Whitebowfr/esp32-poe/BOM.xlsx

BOM pour ESP32-PoE
Nom | Lien | Quantité | Prix total | Remarques
PCB | jlcpcb.com | 5 | 3.2 | (livraison incluse) | TOTAL
ESP-WROOM-32E 4MB | https://www.aliexpress.com/item/1005001560958763.html | 1 | 2.46 |  | 29.4468
Mini DC-DC Buck (6V-32V to 5V) | https://www.aliexpress.com/item/1005005505907937.html? | 1 | 2.45
AMS1117 3.3V | https://www.aliexpress.com/item/1005005350284100.html | 50 | 1.89
TPS2375 | https://www.aliexpress.com/item/1005007349282437.html | 1 | 2.95
TXS0108E (à dessouder) | https://www.aliexpress.com/item/4001336438913.html | 1 | 0.9
Type C Female 16Pin | https://www.aliexpress.com/item/1005007426642375.html | 10 | 1.7 | Bien prendre celle là !! (gros trucs sur les côtés verticaux)
WE-RJ45 LAN Transformer | https://www.we-online.com/en/components/products/WE-LAN-RJ45?sq=7499211125#7499211125 | 1 | 0 | (trop chiant à trouver sur aliexpress donc obligés de passer par wurth)
2P Screw terminal | https://www.aliexpress.com/item/1005007055503766.html | 10 | 1.33
3P Screw terminal | https://www.aliexpress.com/item/1005007055503766.html | 10 | 1.63
CH340C SOP-16 | https://www.aliexpress.com/item/1005004970840775.html | 5 | 1.89
Resistances 0603 33Value x 20pcs | https://www.aliexpress.com/item/33029877427.html | 20 | 1.81
Capa 0603 720 PCS 36 Value | https://www.aliexpress.com/item/1005005398588928.html | 720 | 2.74
Zener 1N4742-12V | https://fr.aliexpress.com/item/1005006121409115.html | 1 | 0.0198
TPS2373 | https://fr.aliexpress.com/item/1005006870094709.html | 1 | 2.94 | Pas bcp moins cher
SMAJ58A | https://fr.aliexpress.com/item/1005004917328273.html | 1 | 0.159
Résistance 1.3k 1/8W | https://fr.aliexpress.com/item/1005005240650820.html | 1 | 0.99 | Kit de 100 mais en vrai on en a au clubelek donc tkt
LAN8710A | https://fr.aliexpress.com/item/1005006944602617.html | 1 | 0.388
