Whitebowfr/esp32-poe/LIB_TPS2373-4RGWR/TPS2373-4RGWR/3D/TPS2373-4RGWR.stp

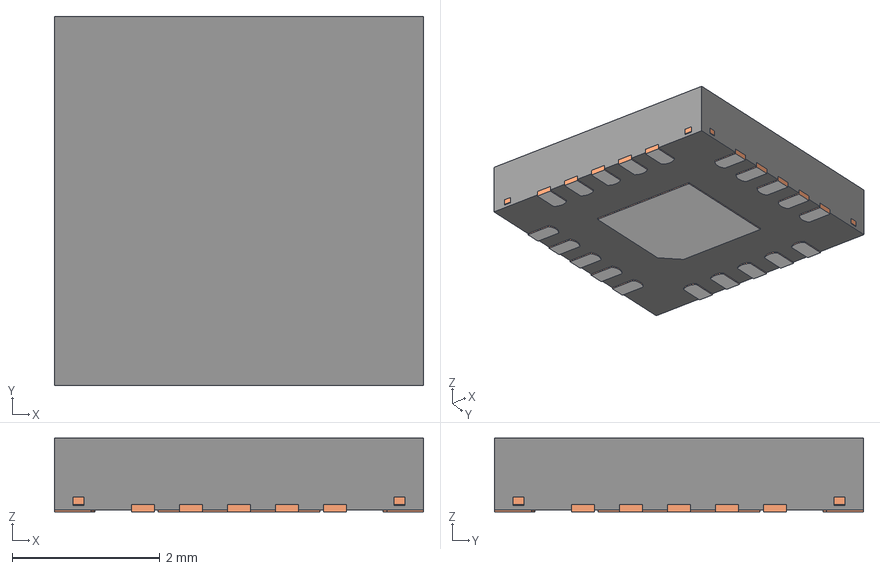
[picture p1: CAD file, 2025-11-28]
LIB_TPS2373-4RGWR/TPS2373-4RGWR/3D/TPS2373-4RGWR.stp
5.00 x 5.00 x 1.00 mm
BODY-QFN
FRAME-RGW0020B
PIN1-ID
