Whitebowfr/esp32-poe/HY931147C/HY931147C.step

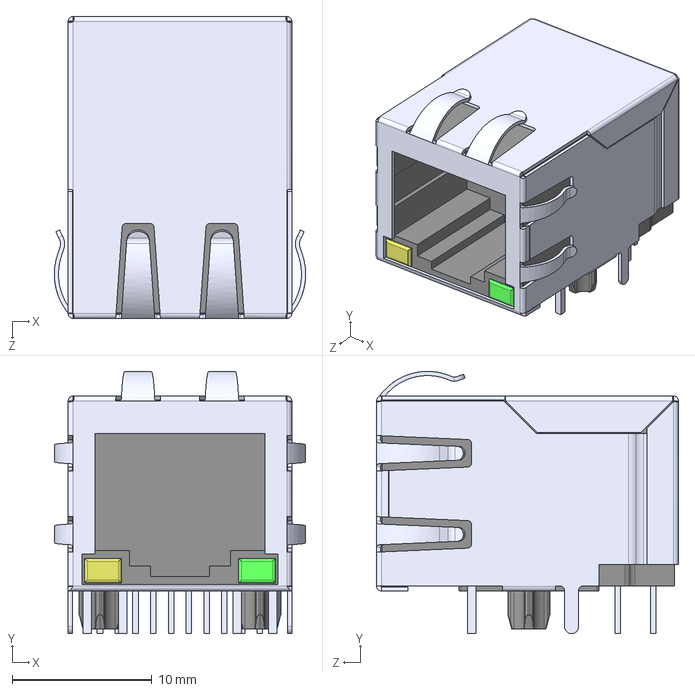
[picture p2: CAD file, 2025-12-01]
HY931147C/HY931147C.step
18.0 x 18.8 x 21.6 mm
