Whitebowfr/esp32-poe/LIB_7499211125/7499211125/3D/7499211125.stp

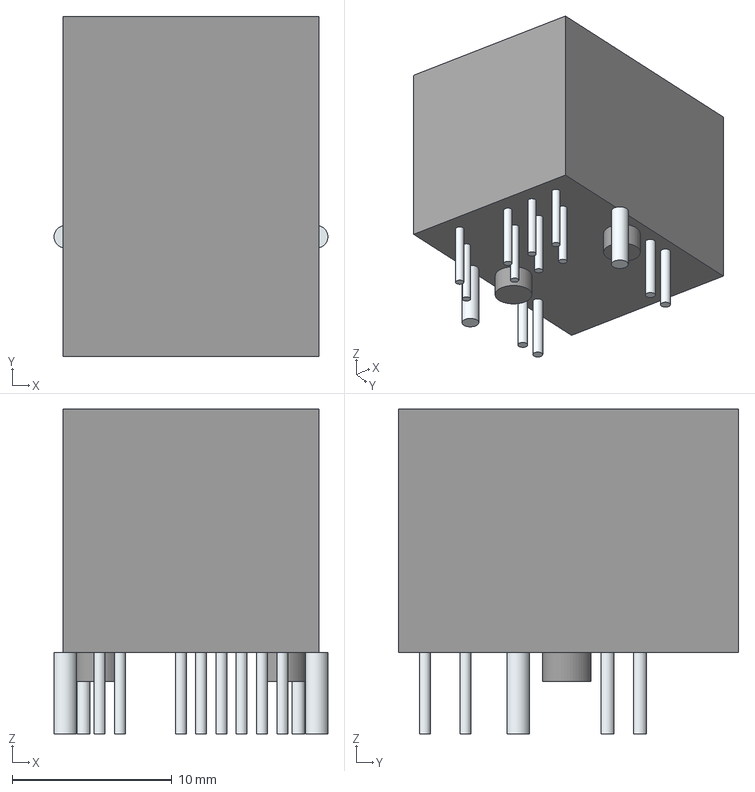
[picture p3: CAD file, 2025-11-28]
LIB_7499211125/7499211125/3D/7499211125.stp
17.1 x 21.3 x 20.4 mm
Lugs
Leads
