Whitebowfr/esp32-poe/(list of files, cad)

Other CAD files:
LIB_7499211125/7499211125/Allegro/7499211125.psm
LIB_7499211125/7499211125/DEHDL/7499211125/chips/chips.prt
LIB_TPS2373-4RGWR/TPS2373-4RGWR/Allegro/qfn65p500x500x100-21n.psm
LIB_TPS2373-4RGWR/TPS2373-4RGWR/DEHDL/tps2373_4rgwr/chips/chips.prt
