Whitebowfr/esp32-poe/(list of files, drawings)

Other design files:
LIB_7499211125/7499211125/Altium/7499211125.PcbLib
LIB_7499211125/7499211125/Altium/7499211125.SchLib
LIB_TPS2373-4RGWR/TPS2373-4RGWR/Altium/QFN65P500X500X100-21N.PcbLib
LIB_TPS2373-4RGWR/TPS2373-4RGWR/Altium/TPS2373-4RGWR.SchLib
