Whitebowfr/esp32-poe/esp32_POE.kicad_pcb

## KiCad design esp32_POE.kicad_pcb (2025-12-06)

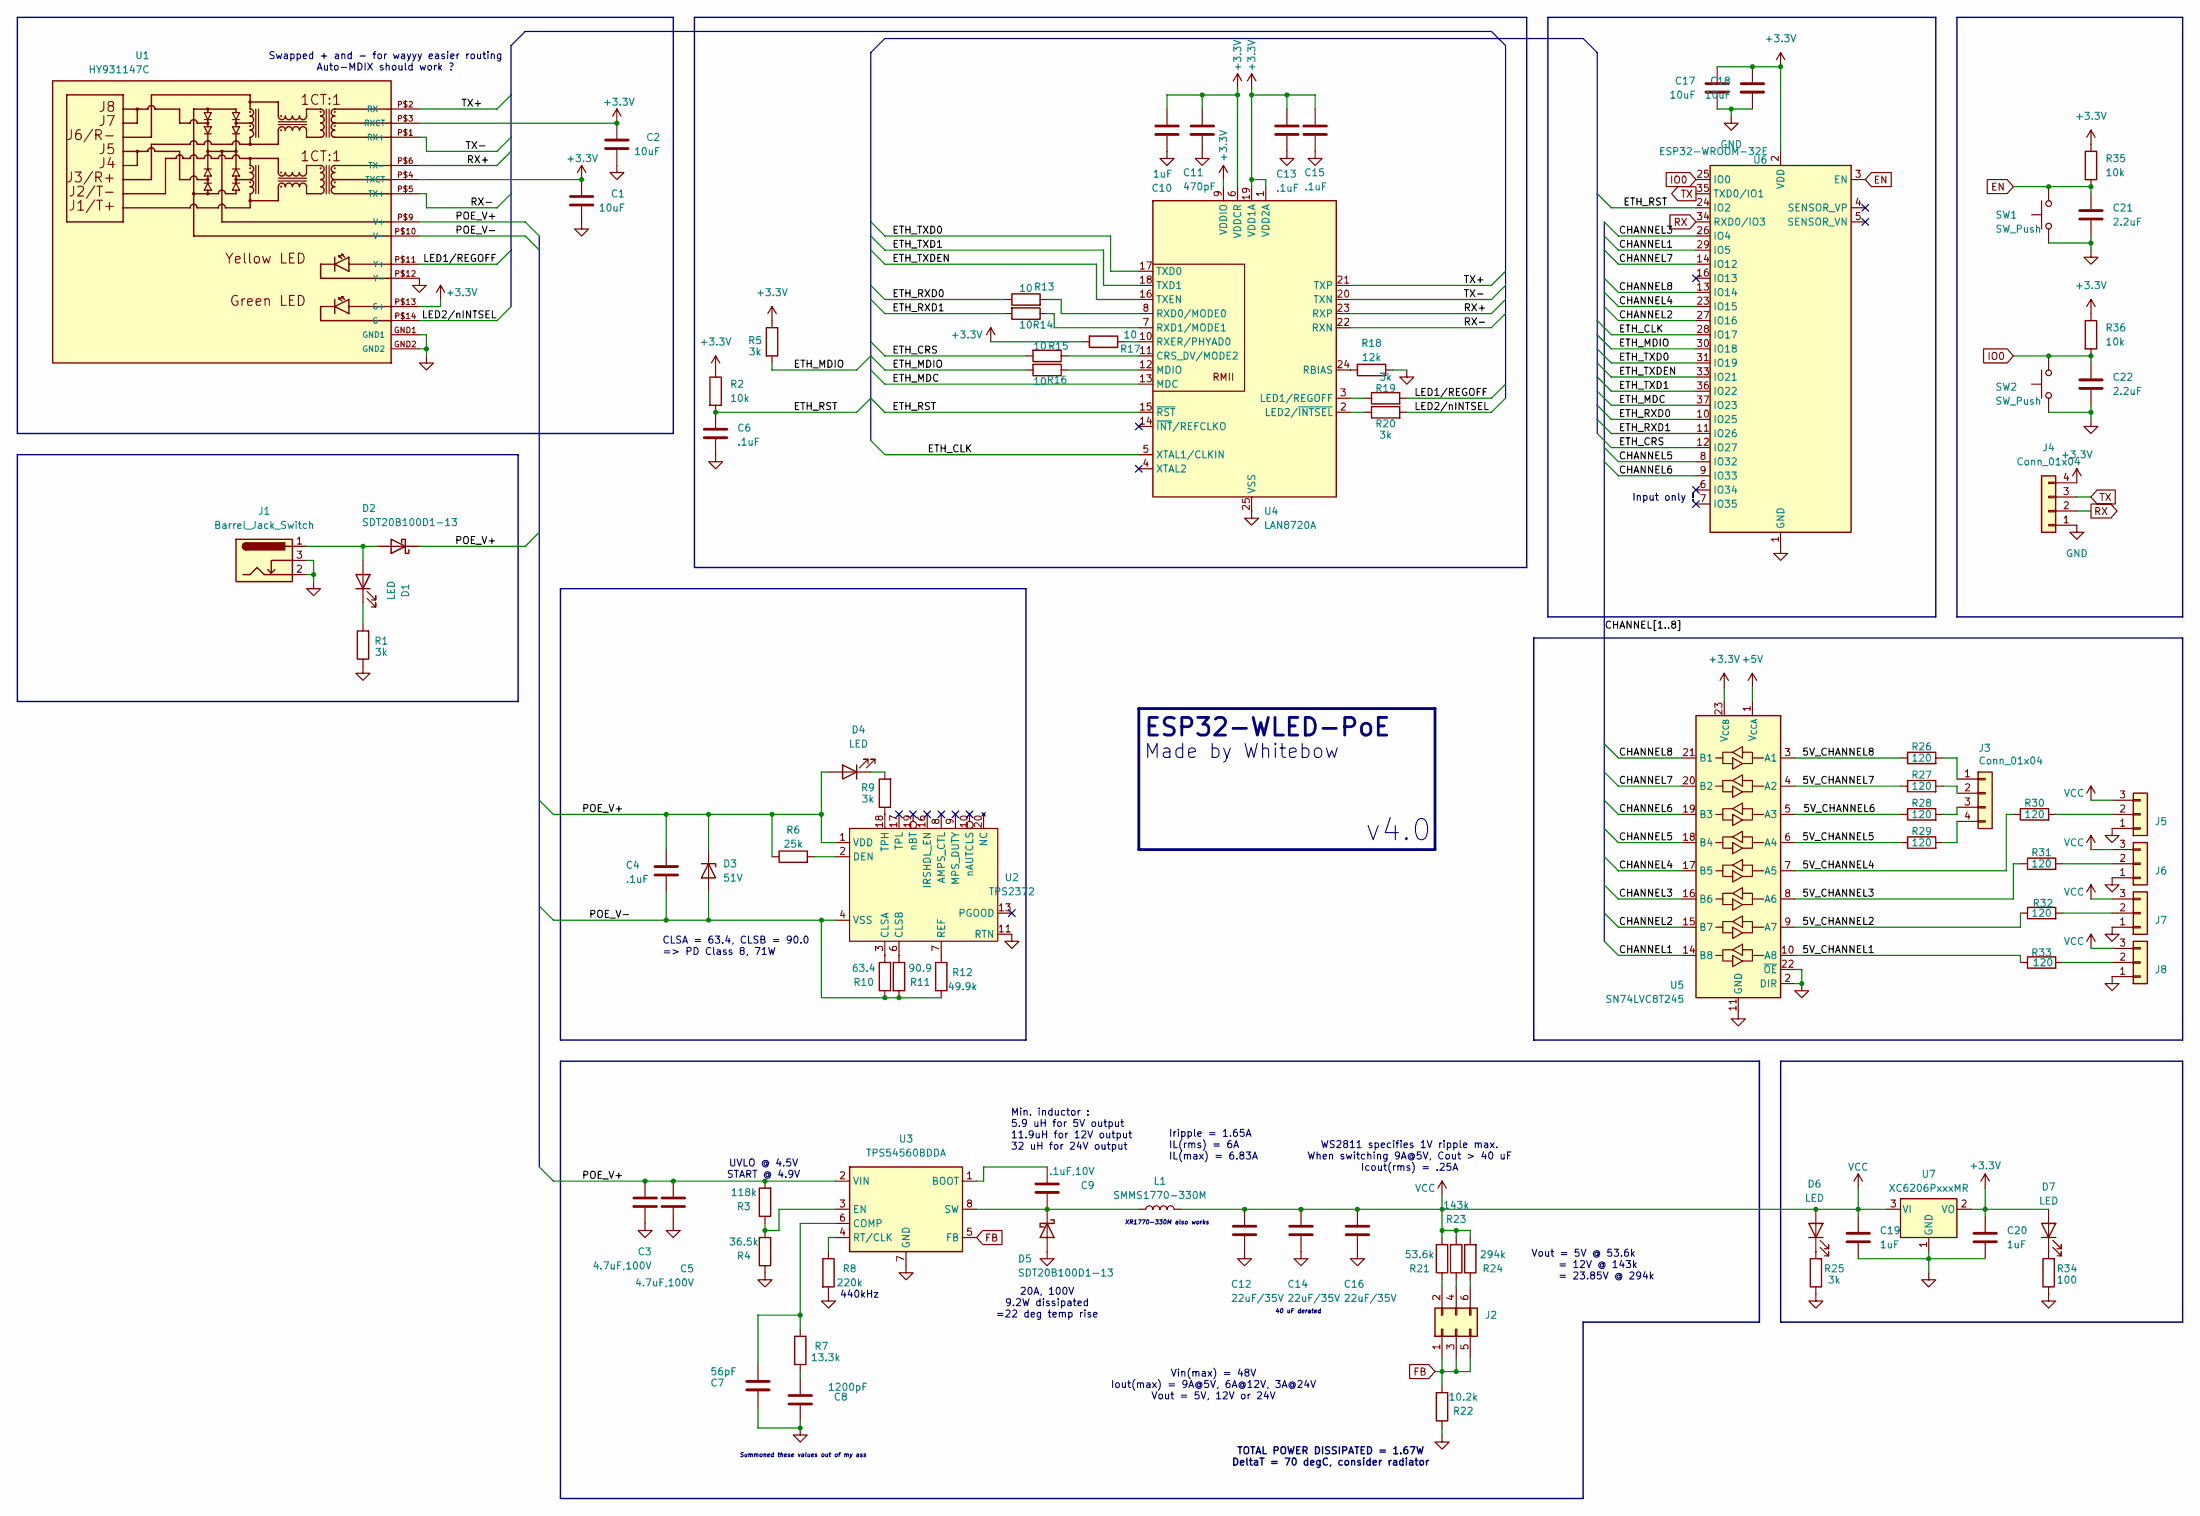
[picture p4: schematic esp32_POE.kicad_sch]

Parts:
C1, C2, C17, C18: 10uF; C_0603_1608Metric
C3, C5: 4.7uF,100V; C_1206_3216Metric
C4, C6, C13, C15: .1uF; C_0603_1608Metric
C7: 56pF; C_0603_1608Metric
C8: 1200pF; C_0603_1608Metric
C9: .1uF,10V; C_0603_1608Metric
C10, C19, C20: 1uF; C_0603_1608Metric
C11: 470pF; C_0603_1608Metric
C12, C14, C16: 22uF/35V; C_0805_2012Metric
C21, C22: 2.2uF; C_0603_1608Metric
D1, D4, D6, D7: LED; LED_0603_1608Metric
D2, D5: SDT20B100D1-13; TO-252-2
D3: 51V; D_SMA
J1: Barrel_Jack_Switch; BarrelJack_Horizontal; LCSC C22459638
J2: Conn_02x03_Odd_Even; PinHeader_2x03_P2.54mm_Vertical
J3: Conn_01x04; PinSocket_1x04_P2.54mm_Vertical
J4: Conn_01x04; PinSocket_1x04_P1.27mm_Vertical
J5, J6, J7, J8: Conn_01x03; JST_XH_B3B-XH-AM_1x03_P2.50mm_Vertical
L1: SMMS1770-330M; L_Vishay_IHLP-6767
R1, R5, R9, R19, R20, R25: 3k; R_0603_1608Metric
R2, R35, R36: 10k; R_0603_1608Metric
R3: 118k; R_0603_1608Metric
R4: 36.5k; R_0603_1608Metric
R6: 25k; R_0603_1608Metric
R7: 13.3k; R_0603_1608Metric
R8: 220k; R_0603_1608Metric
R10: 63.4; R_0603_1608Metric
R11: 90.9; R_0603_1608Metric
R12: 49.9k; R_0603_1608Metric
R13, R14, R15, R16, R17: 10; R_0603_1608Metric
R18: 12k; R_0603_1608Metric
R21: 53.6k; R_0603_1608Metric
R22: 10.2k; R_0603_1608Metric
R23: 143k; R_0603_1608Metric
R24: 294k; R_0603_1608Metric
R26, R27, R28, R29, R30, R31, R32, R33: 120; R_0603_1608Metric
R34: 100; R_0603_1608Metric
SW1, SW2: SW_Push; SW_Push_SPST_NO_Alps_SKRK; LCSC C720477
U1: HY931147C
U2: TPS2372; Texas_RGW0020A_VQFN-20-1EP_5x5mm_P0.65mm_EP3.15x3.15mm
U3: TPS54560BDDA; Texas_R-PDSO-G8_EP2.95x4.9mm_Mask2.4x3.1mm_ThermalVias
U4: LAN8720A; VQFN-24-1EP_4x4mm_P0.5mm_EP2.5x2.5mm_ThermalVias
U5: SN74LVC8T245; TSSOP-24_4.4x7.8mm_P0.65mm
U6: ESP32-WROOM-32E
U7: XC6206PxxxMR; SOT-23-3

Connections:
+3.3V: C1.2, C2.2, C10.2, C11.1, C13.1, C15.1, C17.1, C18.1, C20.1, D7.2 (A), J4.4, R2.1, R5.1, R17.2, R35.1, R36.1, U1.P$3 (RXCT), U1.P$4 (TXCT), U1.P$13 (G+), U4.1 (VDD2A), U4.6 (VDDCR), U4.9 (VDDIO), U4.19 (VDD1A), U5.23 (V_{CCB}), U5.24 (V_{CCB}), U6.2 (VDD), U7.2 (VO)
+5V: U5.1 (V_{CCA})
/5V_CHANNEL1: R33.1, U5.10 (A8)
/5V_CHANNEL2: R32.1, U5.9 (A7)
/5V_CHANNEL3: R31.1, U5.8 (A6)
/5V_CHANNEL4: R30.1, U5.7 (A5)
/5V_CHANNEL5: R29.1, U5.6 (A4)
/5V_CHANNEL6: R28.1, U5.5 (A3)
/5V_CHANNEL7: R27.1, U5.4 (A2)
/5V_CHANNEL8: R26.1, U5.3 (A1)
/CHANNEL1: U5.14 (B8), U6.29 (IO5)
/CHANNEL2: U5.15 (B7), U6.27 (IO16)
/CHANNEL3: U5.16 (B6), U6.26 (IO4)
/CHANNEL4: U5.17 (B5), U6.23 (IO15)
/CHANNEL5: U5.18 (B4), U6.8 (IO32)
/CHANNEL6: U5.19 (B3), U6.9 (IO33)
/CHANNEL7: U5.20 (B2), U6.14 (IO12)
/CHANNEL8: U5.21 (B1), U6.13 (IO14)
/ETH_CLK: U4.5 (XTAL1/CLKIN), U6.28 (IO17)
/ETH_CRS: R15.2, U6.12 (IO27)
/ETH_MDC: U4.13 (MDC), U6.37 (IO23)
/ETH_MDIO: R5.2, R16.2, U6.30 (IO18)
/ETH_RST: C6.1, R2.2, U4.15 (~RST), U6.24 (IO2)
/ETH_RXD0: R13.1, U6.10 (IO25)
/ETH_RXD1: R14.2, U6.11 (IO26)
/ETH_TXD0: U4.17 (TXD0), U6.31 (IO19)
/ETH_TXD1: U4.18 (TXD1), U6.36 (IO22)
/ETH_TXDEN: U4.16 (TXEN), U6.33 (IO21)
/LED1/REGOFF: R19.2, U1.P$11 (Y+)
/LED2/nINTSEL: R20.2, U1.P$14 (G-)
/POE_V+: C3.1, C4.1, C5.1, D2.2 (K), D3.1 (K), D4.2 (A), R3.2, R6.1, U1.P$9 (V+), U2.1 (VDD), U3.2 (VIN)
/POE_V-: C4.2, D3.2 (A), R10.1, R11.2, R12.2, U1.P$10 (V-), U2.4 (VSS), U2.5 (VSS), U2.21 (EPAD)
/RX+: U1.P$6 (TX-), U4.23 (RXP)
/RX-: U1.P$5 (TX+), U4.22 (RXN)
/TX+: U1.P$2 (RX-), U4.21 (TXP)
/TX-: U1.P$1 (RX+), U4.20 (TXN)
EN: C21.1, R35.2, SW1.2, U6.3 (EN)
FB: J2.1, J2.3, J2.5, R22.2, U3.5 (FB)
GND: C1.1, C2.1, C3.2, C5.2, C6.2, C7.1, C8.1, C10.1, C11.2, C12.2, C13.2, C14.2, C15.2, C16.2, C17.2, C18.2, C19.2, C20.2, C21.2, C22.2, D5.1 (A), D5.3 (A), J1.2, J1.3, J4.1, J5.1, J6.1, J7.1, J8.1, R1.1, R4.1, R8.2, R18.1, R22.1, R25.1, R34.1, SW1.1, SW2.1, U1.GND1, U1.GND2, U1.P$12 (Y-), U2.11 (RTN), U2.12 (RTN), U3.7 (GND), U3.9 (GND), U4.25 (VSS), U5.2 (DIR), U5.11 (GND), U5.12 (GND), U5.13 (GND), U5.22 (~OE), U6.1 (GND), U6.15 (GND), U6.38 (GND), U6.39 (GND), U7.1 (GND)
IO0: C22.1, R36.2, SW2.2, U6.25 (IO0)
unnamed: C8.2, R7.2
unnamed: D1.2 (A), D2.1 (A), D2.3 (A), J1.1
unnamed: D1.1 (K), R1.2
unnamed: D4.1 (K), R9.2
unnamed: C9.1, D5.2 (K), L1.1, U3.8 (SW)
unnamed: D6.1 (K), R25.2
unnamed: D7.1 (K), R34.2
unnamed: J2.2, R21.1
unnamed: J2.4, R23.1
unnamed: J2.6, R24.1
unnamed: J3.1, R26.2
unnamed: J3.2, R27.2
unnamed: J3.3, R28.2
unnamed: J3.4, R29.2
unnamed: J5.2, R30.2
unnamed: J6.2, R31.2
unnamed: J7.2, R32.2
unnamed: J8.2, R33.2
unnamed: R10.2, U2.3 (CLSA)
unnamed: R11.1, U2.6 (CLSB)
unnamed: R6.2, U2.2 (DEN)
unnamed: R12.1, U2.7 (REF)
unnamed: R9.1, U2.18 (TPH)
unnamed: C9.2, U3.1 (BOOT)
unnamed: C7.2, R7.1, U3.6 (COMP)
unnamed: R3.1, R4.2, U3.3 (EN)
unnamed: R8.1, U3.4 (RT/CLK)
unnamed: R15.1, U4.11 (CRS_DV/MODE2)
unnamed: R19.1, U4.3 (LED1/REGOFF)
unnamed: R20.1, U4.2 (LED2/~INTSEL)
unnamed: R16.1, U4.12 (MDIO)
unnamed: R18.2, U4.24 (RBIAS)
unnamed: R13.2, U4.8 (RXD0/MODE0)
unnamed: R14.1, U4.7 (RXD1/MODE1)
unnamed: R17.1, U4.10 (RXER/PHYAD0)
RX: J4.2, U6.34 (RXD0/IO3)
TX: J4.3, U6.35 (TXD0/IO1)
VCC: C12.1, C14.1, C16.1, C19.1, D6.2 (A), J5.3, J6.3, J7.3, J8.3, L1.2, R21.2, R23.2, R24.2, U7.3 (VI)

Notes on the sheet:
ESP32-WLED-PoE
Vout = 5V @ 53.6k = 12V @ 143k = 23.85V @ 294k
CLSA = 63.4, CLSB = 90.0 => PD Class 8, 71W
TOTAL POWER DISSIPATED = 1.67W DeltaT = 70 degC, consider radiator
Iripple = 1.65A IL(rms) = 6A IL(max) = 6.83A
XR1770-330M also works
Input only !
440kHz
Made by Whitebow
Swapped + and - for wayyy easier routing Auto-MDIX should work ?
40 uF derated
Vin(max) = 48V Iout(max) = 9A@5V, 6A@12V, 3A@24V Vout = 5V, 12V or 24V
UVLO @ 4.5V START @ 4.9V
Min. inductor : 5.9 uH for 5V output 11.9uH for 12V output 32 uH for 24V output
Summoned these values out of my ass
WS2811 specifies 1V ripple max. When switching 9A@5V, Cout > 40 uF Icout(rms) = .25A
20A, 100V 9.2W dissipated =22 deg temp rise
v4.0

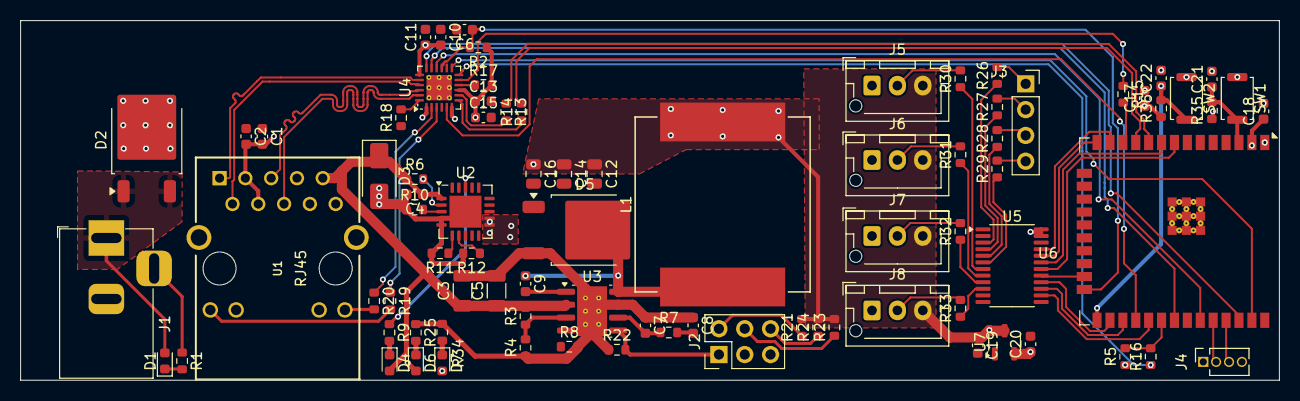
[picture p5: board esp32_POE.kicad_pcb from above]

Board: 4 copper layers, 123.9 x 35.4 mm, 83 parts (0 on the bottom side), 77 nets.
