Whitebowfr/esp32-poe/(commit log)

2025-11-30 Modified schematic : fixed esp32 circuit, changed to SN74 level shifter, changed to LAN8270
    [esp32_POE.kicad_pcb]
2025-12-01 Finished setting up the schematic, started basic routing
    [HY931147C.step, esp32_POE.kicad_pcb, esp32_POE.kicad_sch]
2025-12-03 Finished up roughing pass, reduced pcb size
    [esp32_POE.kicad_pcb]
2025-12-06 Finished 1st routing pass, reduced size of PCB
    [esp32_POE.kicad_pcb, esp32_POE.kicad_sch]
2025-12-06 Dropped files in gitignore
    [BOM-esp32_POE.csv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]
